Babtsov/Senior-Design/(commit log)

2016-10-26 transmit 'a' through UART!
2016-10-26 transmit and receive UART!
2016-10-26 Add interrupt driven UART echo
2016-10-27 Added push button for in between scanning
2016-11-01 Added 4 button functionality
2016-11-01 Added time UI with 4 buttons
2016-11-01 Added preliminary timer functionality & move globals up
2016-11-01 Adjusted timer count approx 1 sec for clk 1Mhz
2016-11-02 Added 5th button (OK)
2016-11-02 The right button is the implicit OK
2016-11-04 Cards are now acknoledged in any screen we are currently in
2016-11-10 Add datasheet and make UART work on the 644
2016-11-11 Added functionality for 2nd UART 9600 baud
2016-11-11 Fix 1 second timer to tick every 1 second
2016-11-13 Migrate to Flask Framework
2016-11-21 disable rouge interrupts and get rid of message passing :(
2016-11-22 Fixed UART to work properly with the main board
